Kartik-Aggarwal/Terrace-Farming-Robot/arduino_codes/motor_servo/motor_servo.ino

#define ENA   14          // Enable/speed motors Right        GPIO14(D5)
#define ENB   12          // Enable/speed motors Left         GPIO12(D6)
#define IN_1  15          // L298N in1 motors Right           GPIO15(D8)
#define IN_2  13          // L298N in2 motors Right           GPIO13(D7)
#define IN_3  2           // L298N in3 motors Left            GPIO2(D4)
#define IN_4  0           // L298N in4 motors Left            GPIO0(D3)

#include <ESP8266WiFi.h>
#include <WiFiClient.h>
#include <ESP8266WebServer.h>

String command;             //String to store app command state.
int speedCar = 800;         // 400 - 1023.
int speed_Coeff = 3;

const char* ssid = "IITJ_WLAN";
const char* pass = "garvit32";
ESP8266WebServer server(80);

void setup() {

  pinMode(ENA, OUTPUT);
  pinMode(ENB, OUTPUT);
  pinMode(IN_1, OUTPUT);
  pinMode(IN_2, OUTPUT);
  pinMode(IN_3, OUTPUT);
  pinMode(IN_4, OUTPUT);
  

  Serial.begin(115200);

  // Connecting WiFi

  WiFi.mode(WIFI_AP);
  WiFi.softAP(ssid, pass);

  IPAddress myIP = WiFi.softAPIP();
  Serial.print("AP IP address: ");
  Serial.println(myIP);

  // Starting WEB-server
  server.on ( "/", HTTP_handleRoot );
  server.onNotFound ( HTTP_handleRoot );
  server.begin();
}

void goUp_1() {

  digitalWrite(IN_1, LOW);
  digitalWrite(IN_2, HIGH);
  analogWrite(ENA, speedCar);


}

void goDown_1() {



  digitalWrite(IN_1, HIGH);
  digitalWrite(IN_2, LOW);
  analogWrite(ENB, speedCar);
}

void goUp_2() {

  digitalWrite(IN_3, LOW);
  digitalWrite(IN_4, HIGH);
  analogWrite(ENB, speedCar);
}

void goDown_2() {


  digitalWrite(IN_3, HIGH);
  digitalWrite(IN_4, LOW);
  analogWrite(ENB, speedCar);
}

void goUp_Both() {

  digitalWrite(IN_1, LOW);
  digitalWrite(IN_2, HIGH);
  analogWrite(ENA, speedCar);

  digitalWrite(IN_3, LOW);
  digitalWrite(IN_4, HIGH);
  analogWrite(ENB, speedCar);
}

void goDown_Both() {

  digitalWrite(IN_1, HIGH);
  digitalWrite(IN_2, LOW);
  analogWrite(ENA, speedCar);

  digitalWrite(IN_3, HIGH);
  digitalWrite(IN_4, LOW);
  analogWrite(ENB, speedCar);
}


void stopRobot() {

  digitalWrite(IN_1, LOW);
  digitalWrite(IN_2, LOW);
  analogWrite(ENA, speedCar);

  digitalWrite(IN_3, LOW);
  digitalWrite(IN_4, LOW);
  analogWrite(ENB, speedCar);
}

void loop() {
  server.handleClient();

  command = server.arg("State");
  if (command == "F") goUp_1();
  else if (command == "B") goDown_1();
  else if (command == "L") goUp_2();
  else if (command == "R") goDown_2();
  else if (command == "I") goUp_Both();
  else if (command == "G") goDown_Both();
  else if (command == "0") speedCar = 400;
  else if (command == "1") speedCar = 470;
  else if (command == "2") speedCar = 540;
  else if (command == "3") speedCar = 610;
  else if (command == "4") speedCar = 680;
  else if (command == "5") speedCar = 750;
  else if (command == "6") speedCar = 820;
  else if (command == "7") speedCar = 890;
  else if (command == "8") speedCar = 960;
  else if (command == "9") speedCar = 1023;
  else if (command == "S") stopRobot();
}



void HTTP_handleRoot(void) {

  if ( server.hasArg("State") ) {
    Serial.println(server.arg("State"));
  }
  server.send ( 200, "text/html", "" );
  delay(1);
}
