Kartik-Aggarwal/Terrace-Farming-Robot/arduino_codes/servo_nodemcu/servo_nodemcu.ino

#define BLYNK_PRINT Serial
#include <ESP8266WiFi.h>
#include <BlynkSimpleEsp8266.h>
#include <Servo.h>

Servo servo;

char auth[] = "mZt2ihDNd_C1foi7e17Aj3n0AN0U0rf9";
char ssid[] = "Mini";
char pass[] = "garvit32";

void setup()
{
  Serial.begin(9600);
  Blynk.begin(auth, ssid, pass);

  servo.attach(15); // NodeMCU D8 pin

}

void loop()
{

  Blynk.run();

}
BLYNK_WRITE(V1)
{
  servo.write(param.asInt());
}

BLYNK_WRITE(V2)
{
  servo.write(0);
}
BLYNK_WRITE(V3)
{
  servo.write(90);
}
BLYNK_WRITE(V4)
{
  servo.write(180);
}
